seojun-1266/smart-farm-iot-2024/hardware/README.md

# 하드웨어 · 핀 배치

배선도: [`wiring_ceiling.svg`](wiring_ceiling.svg) · [`wiring_floor.svg`](wiring_floor.svg)
(펌웨어 코드의 핀 정의를 기준으로 작성. 모든 모듈 VCC → 5V, GND → GND 공통)

## 천장 아두이노 (`firmware/ceiling`)

| 핀 | v1 (2024-06) | v2 (2024-08) |
|---|---|---|
| D6 | — | 네오픽셀 RGBW 60구 DIN |
| D7 | 초음파 TRIG | 초음파 TRIG |
| D8 | 초음파 ECHO | 초음파 ECHO |
| D9 | 서보 (지붕 창문) | 서보 (지붕 창문) |
| D10 | — | 버튼 (INPUT_PULLUP, 팬 토글) |
| D11 | — | DC 팬 |
| D12 | LED | — |
| D13 | 부저 | 부저 |
| A0 | 조도 센서 | 조도 센서 |
| A4 / A5 | I2C LCD SDA / SCL (0x27) | I2C LCD SDA / SCL (0x27) |

## 바닥 아두이노 (`firmware/floor`)

| 핀 | v1 (2024-06) | v2 (2024-08) |
|---|---|---|
| D2 · D3 | 키패드 COL2 · COL1 | 키패드 ROW4 · ROW3 |
| D4 · D5 | 키패드 ROW2 · ROW1 | 키패드 ROW2 · ROW1 |
| D6 | DHT11 DATA | DHT11 DATA |
| D7 | 가습기 모듈 | 가습기 모듈 |
| D8 | LED | LED |
| D9 | HC-06 TXD → (SoftwareSerial RX) | 동일 |
| D10 | HC-06 RXD ← (SoftwareSerial TX) | 동일 |
| D11 | DC 팬 | DC 팬 |
| D12 | 서보 (출입문) | 서보 (출입문) |
| D13 | 부저 | 부저 |
| A0 | 토양 수분 센서 | 토양 수분 센서 ⚠️ + 키패드 COL4 |
| A1 | 조도 센서 | 조도 센서 ⚠️ + 키패드 COL3 |
| A2 | 불꽃 감지 센서 | 불꽃 감지 센서 ⚠️ + 키패드 COL2 |
| A3 | — | 키패드 COL1 |

⚠️ v2는 4x4 키패드의 열을 A0~A3에 연결해 아날로그 센서 핀과 겹칩니다.
같은 핀을 동시에 쓸 수 없으므로, 다시 만든다면 I2C 키패드 모듈이나 아날로그 핀이 많은 보드(Mega)를 쓰는 것이 맞습니다.

## 부품 목록

| 부품 | 수량 | 용도 |
|---|---|---|
| Arduino UNO | 2 | 천장 / 바닥 제어 |
| HC-06 블루투스 모듈 | 1 | 앱 통신 |
| SG90 서보 모터 | 2 | 지붕 창문 / 출입문 |
| 4x4 멤브레인 키패드 | 1 | 비밀번호 입력 |
| HC-SR04 초음파 센서 | 1 | 작물 높이 측정 |
| DHT11 온습도 센서 | 1 | 온습도 측정 |
| 토양 수분 센서 | 1 | 급수 판단 |
| 조도 센서 (CdS) | 2 | 창문·조명 제어 |
| 불꽃 감지 센서 | 1 | 팬 제어 |
| 가습기(초음파 분무) 모듈 | 1 | 급수 |
| I2C LCD 16x2 | 1 | 수확 알림 표시 |
| 네오픽셀 RGBW 스트립 60구 | 1 | 생장등 (v2) |
| DC 팬, 푸시 버튼, LED, 부저 | — | — |
