seojun-1266/smart-farm-iot-2024/app/assets/Sign.png

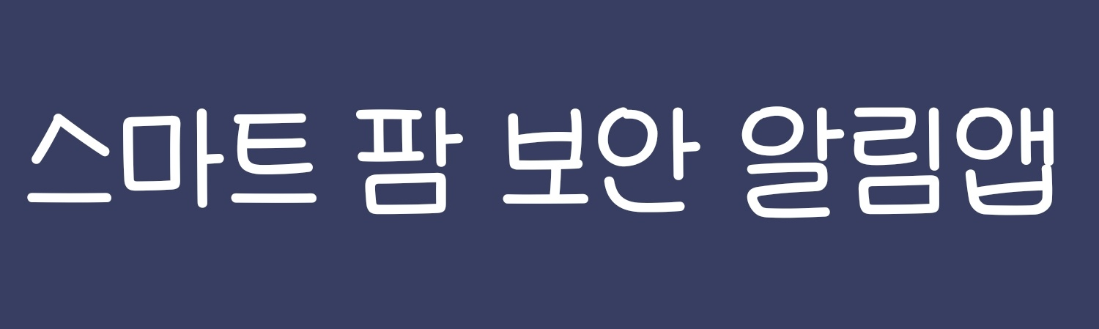
app/assets/Sign.png
