seojun-1266/smart-farm-iot-2024/app/assets/siren.png

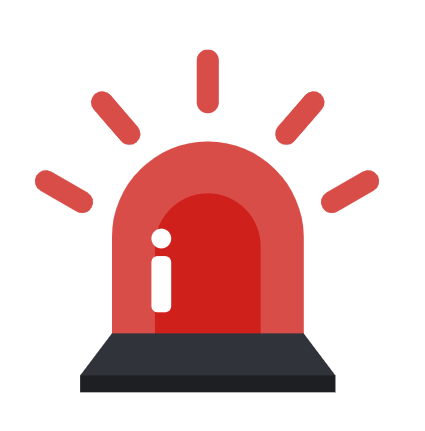
app/assets/siren.png
