seojun-1266/smart-farm-iot-2024/app/assets/Temperature and humidity.png

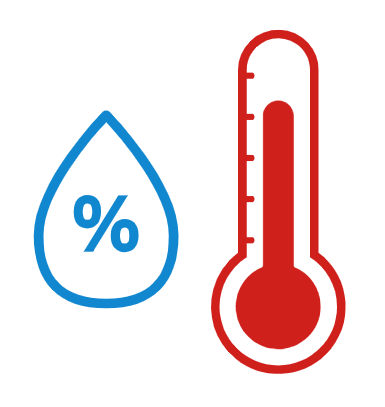
app/assets/Temperature and humidity.png
