seojun-1266/smart-farm-iot-2024/firmware/tests/README.md

# 단위 테스트 스케치

부품을 하나씩 검증한 뒤 `floor.ino` / `ceiling.ino`로 통합했습니다. (괄호 안은 2024년 당시 파일 이름)

| 폴더 | 내용 | 작성일 |
|---|---|---|
| `ultrasonic_intruder` (sketch_apr4a) | 초음파로 20 cm 안에 물체가 오면 블루투스로 `danger` 전송 | 2024-05-30 |
| `analog_sensor_read` (chimipja) | 아날로그 센서 값 읽기 | 2024-06-03 |
| `soil_moisture` (toyeong) | 토양 수분 센서 값 읽기 | 2024-06-04 |
| `fan_motor` (mini_fan) | DC 팬 회전 | 2024-06-04 |
| `keypad_lock` (password) | 키패드 비밀번호 → 서보 + 부저 | 2024-06-06 |
| `dht_bluetooth` (Temp_APP) | DHT11 온습도를 블루투스로 앱에 전송 | 2024-06-06 |
| `keypad_bluetooth` (Password_App) | 키패드 비밀번호 결과를 앱으로 전송 | 2024-06-06 |
| `humidifier_auto` (onsepdo_gasepgi) | 습도에 따라 가습기 ON/OFF | 2024-06-06 |
