seojun-1266/smart-farm-iot-2024/(commit log)

2024-05-30 앱: App Inventor 첫 버전 (블루투스 수신, danger 수신 시 음성 알림)
2024-05-30 테스트: 초음파 거리로 침입 감지 후 블루투스 전송
2024-06-03 테스트: 아날로그 센서 값 읽기
2024-06-04 테스트: 토양 수분 센서
2024-06-04 테스트: DC 팬 모터
2024-06-04 바닥: 토양·조도·불꽃 센서와 가습기·LED·팬 통합
2024-06-05 바닥: 키패드 출입문, DHT11, 블루투스 통합
2024-06-06 테스트: 키패드 비밀번호 잠금 (서보 + 부저)
2024-06-06 테스트: DHT11 온습도 블루투스 전송
2024-06-06 테스트: 키패드 결과를 앱으로 전송
2024-06-06 앱: 0/1 신호로 정상·침입자 발생 표시
2024-06-06 테스트: 습도에 따른 가습기 자동 제어
2024-06-10 앱: 화면 디자인용 아이콘 (간판, 사이렌, 온습도)
2024-06-11 앱: 전시 전 수정본 (06.11 저장)
2024-06-11 앱: 화면 디자인 적용 (아이콘 이미지, 사용하지 않는 BLE 블록 정리)
2024-06-12 천장: 초음파 수확 알림 + 조도 기반 지붕 창문 서보
2024-06-12 바닥: 전시회 최종 (블루투스 0/1 신호, 한글 온습도 전송)
    2026 복원 메모: 카카오톡으로 전달되며 빠진 #include <Keypad.h> 한 줄 보충
2024-06-13 앱: 전시회 최종 (테스트용 danger/good 처리 제거)
2024-08-07 천장: 네오픽셀 생장등 60구 + 팬 토글 버튼 추가 (홍보영상용 재제작)
2024-08-09 바닥: 4x4 키패드 전체 배선, 온도 보정
    2026 복원 메모: 실수로 붙여넣어진 시리얼 모니터 출력 부분 제거
2026-10-28 하드웨어: 배선도(SVG)와 핀 배치표 추가
2026-10-28 문서: 제작 사진과 시연 GIF
2026-10-28 문서: README 작성
2026-10-28 문서: 재제작 참여 팀원 추가
2026-10-28 문서: 홍보영상 출연자와 역할 정리
2026-10-28 문서: 학년 표기 추가
2026-10-28 문서: 회고에 홍보영상 관련 아쉬운 점 추가
2026-10-28 문서: README 표현 다듬기 (부품 수, 역할, 보드 분리 이유 정확히)
